liaochikon/ALTO-3D-Printed-6-Axis-Robotic-Arm/hardware/alto_bom.xlsx

Parts Name | Part Detail | Qty | Shop Page | P.S.
main board | STM32F407 | 1 | https://shopee.tw/-%E7%89%A9%E8%81%AF%E6%B1%AA%E6%B1%AA-%E9%99%84%E7%99%BC%E7%A5%A8~-%E5%8E%9F%E5%BB%A0STM32F407-STM32F407G-DISC1-STM32F4Discovery%E9%96%8B%E7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 | 主板
can transceiver | SN65HVD230 | 1 | https://shopee.tw/%E6%B2%85%E5%AE%87%E9%9B%BB%E5%AD%90230-%E7%B8%BD%E7%B7%9A%E6%94%B6%E7%99%BC%E5%99%A8-SN65HVD230-CAN%E9%80%9A%E4%BF%A1%E6%A8%A1%E5%A1%8A-i.9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
stepper driver | Nema14 stepper driver | 3 | https://item.taobao.com/item.htm?spm=2013.1.w4004-23494047120.32.20f71b88f6Hh1f&id=736578173538 | Emm35_V5.0 CAN套餐
stepper driver | Nema17 stepper driver | 3 | https://item.taobao.com/item.htm?spm=2013.1.w4023-23494047119.4.1f9c1c5aKUlyCU&id=673302946671 | Emm42_V5.0 CAN套餐
power supply | 12V PSU | 1 | https://shopee.tw/product/61466000/1941613159?gad_source=1
stepper motor | Nema17 40mm | 1 | https://zhangdatou.world.taobao.com/category-1664861154.htm?search=y&catName=%B2%BD%BD%F8%B1%D5%BB%B7 | 40mm
stepper motor | Nema17 48mm | 1 | https://zhangdatou.world.taobao.com/category-1664861154.htm?search=y&catName=%B2%BD%BD%F8%B1%D5%BB%B7 | 48mm
stepper motor | Nema17 34mm | 1 | https://zhangdatou.world.taobao.com/category-1664861154.htm?search=y&catName=%B2%BD%BD%F8%B1%D5%BB%B7 | 34mm
stepper motor | Nema14 28mm | 3 | https://item.taobao.com/item.htm?id=723690490192 | 28mm
Gearbox | CSF 11-50 | 2 | https://item.taobao.com/item.htm?abbucket=9&id=702811518003&ns=1&spm=a21n57.1.0.0.25af523cLsaGRe | CSF 11-50
Gearbox | CSF 11-30 | 1 | https://item.taobao.com/item.htm?abbucket=9&id=702811518003&ns=1&spm=a21n57.1.0.0.25af523cLsaGRe | CSF 11-30
Gearbox | CSF 8-30 | 3 | https://item.taobao.com/item.htm?abbucket=9&id=702811518003&ns=1&spm=a21n57.1.0.0.25af523cLsaGRe | CSF 8-30
bearings | Rb-4510 | 2 | https://detail.tmall.com/item.htm?abbucket=9&id=620473594888&ns=1&skuId=5198515463595 | RB4510UUCC0P5
bearings | Rb-3510 | 1 | https://detail.tmall.com/item.htm?abbucket=9&id=620473594888&ns=1&skuId=5198515463597 | RB3510UUCC0P5
limit switch | SS_5_F | 6 | https://shopee.tw/%E5%BE%AE%E5%8B%95%E9%96%8B%E9%97%9C-%E6%AD%90%E5%A7%86%E9%BE%8D-SS-5F-SS-5GL-SS-5GL2-%E9%99%90%E4%BD%8D%E9%96%8B%E9%97%9C-%E8%B6%85%E8%80%9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 | SS-5-F 無柄
shaft | 5mm_shaft_30mm | 2 | https://shopee.tw/product/149365831/2264547240 | 5x30{10個}
pulley | GT2_20teeth_5mm | 4 | https://shopee.tw/product/493468305/14223175476 | 2GT鋁同步輪(20齒5mm孔)
timing belt | GT2_5mm_260mm timing belt | 2 | https://shopee.tw/(%E7%84%A1%E7%99%BC%E7%A5%A8)-3D%E5%88%97%E5%8D%B0-2GT-%E5%B8%B6%E5%AF%AC6MM%E6%9C%89110~200~420~600%E7%92%B0%E5%BD%A2%E9%96%89%E5%8F%A3%E5%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 | 圓周長260
nut | M3_nut | 4
nut | M4_nut | 6
nut | M8_Nut | 4
screw | Hex_m3x10 | 6
screw | Hex_m3x15 | 12
screw | Hex_m3x20 | 17
screw | Hex_m3x25 | 20
screw | Hex_m4x10 | 10
screw | Hex_m4x20 | 6
screw | Hex_m8x45 | 4
screw | Flat_m2.5x10 | 12
3D printed part | Base_upper_frame | 1
3D printed part | Base_lower_frame | 1
3D printed part | Joint_1_frame | 1
3D printed part | Joint_2_frame | 1
3D printed part | Joint_3_frame | 1
3D printed part | Joint_4_frame | 1
3D printed part | Joint_5_frame | 1
3D printed part | Joint_2_cover | 1
3D printed part | Joint_4_cover | 1
3D printed part | Gearhead_cover | 2
3D printed part | Flange_base | 1
3D printed part | Flange_cover | 1
