liaochikon/ALTO-3D-Printed-6-Axis-Robotic-Arm/(threads)

Thread 1 (2024-05-20):

BOM links not working

SwannSchilling, 2024-05-20:
Hey there although its been updated recently the links seem to not be valid anymore!
I am super interested in those harmonic drives, could you check those links please?
This would be super helpful!

liaochikon, 2024-05-20:
The page to buy the stepper driver and harmonic drives were gone a few month ago.
I've managed to find another store for the harmonic drives, but still looking for alternatives for stepper driver.
Currently planning to make my own stepper driver board.

Here's link for harmonic drives:
https://world.taobao.com/item/702811518003.htm?spm=a21wu.10013406-tw.taglist-content.2.460340f1MlBiPW
Hope this would help~

SwannSchilling, 2024-05-20:
Thank you so much!! This is great news!
They used to be so costly! I will order them right now!! :)

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

SwannSchilling, 2024-05-20:
I will close it as resolved! :)

Closed 2024-05-20.

Thread 4 (2025-05-30):

Control board integration

hhoow1234, 2025-05-30:
Design a I/O board for stm32 and power board module installation.

hhoow1234, 2025-07-25:
@liaochikon
Please update the develop progress, thank you.

Thread 8 (2025-05-31):

3D print supplier

hhoow1234, 2025-05-31:
【淘宝】36%买家复购 https://e.tb.cn/h.6xKX5w9yUuzThZL?tk=7JdCVnqOuGM tG-#22>lD 「FDM 3D打印服务打样高强度ABS阻燃ASA PC PET尼龙PA碳纤 PETG TPU」
点击链接直接打开 或者 淘宝搜索直接打开

【淘宝】34%买家复购 https://e.tb.cn/h.6xm3PJvwMSFdc4W?tk=wEW5VnqoCyj tG-#22>lD 「3d打印服务模型定制全透明高韧性树脂光固化工业级高精度制作建模」
点击链接直接打开 或者 淘宝搜索直接打开

Thread 10 (2025-07-24):

Functional safty requirment

hhoow1234, 2025-07-24:
**1. Emergency Stop (E-Stop)**

- Must comply with ISO 13850
- Hardware-based physical button that immediately stops the robot when pressed
- Must cut power or disable drive signals
- Reset must be manual, not automatic
- Should have redundancy and self-monitoring

**2. Safe Torque Off (STO)**

- Prevents motor from generating torque, even if the control system fails
- Typically implemented within the motor driver/inverter
- Must comply with IEC 61800-5-2
- Ensures the robot cannot move under fault conditions

**3. Collision Detection & Force Limiting**

- Detects abnormal contact with objects or humans
- Limits force or torque applied by the joints/end-effector

- Can use:

   Motor current monitoring

   Joint torque sensors

   External force/torque sensors

   Especially important for collaborative robots (refer to ISO/TS 15066)

**4. Joint & Axis Limit Protection**

- Defines both hardware and software limits for each axis
- Prevents mechanical overtravel that could damage the arm or injure people
- Can be implemented using limit switches, encoders, or internal logic

**5. Safe Speed and Safe Zones**

- Limits the speed of the robot when operating in sensitive or shared workspaces
- Integrates with safety devices such as:
- Light curtains
- Laser scanners
- Safety-rated cameras
- Automatically switches to low-speed mode or stops when a person approaches

**6. Redundancy and Fault Monitoring**

- Safety-critical systems must use dual-channel redundancy
- Continuous self-monitoring for failures in:
- Sensors
- Actuators
- Control logic
- Use watchdog timers and fault-tolerant logic

**7. Power-On Safety Check**

- System must verify:
- Emergency stop is not engaged
- No limit switches are triggered
- Drives are disabled by default
- Robot should not move automatically on startup

**8. Safe State on Power Loss**

- Robot must default to a safe state during power interruption or critical faults
- Includes automatic brake engagement or gravity compensation mechanisms
- Prevents uncontrolled movements (e.g., falling arms)

**9. Software Safety Protections**

- All safety-related software should be:
   Modular
   Tested and validated
   Designed with fail-safe conditions
   Includes overflow protections, watchdogs, and input signal validation
